pbrugugnoli/Laboratory-Oven/NODEMCU_ESP12E_code/NODEMCU_ESP12E_code.ino

// Example Arduino/ESP8266 code to upload data to Google Sheets
// Follow setup instructions found here:
// https://github.com/StorageB/Google-Sheets-Logging
// 
// email: StorageUnitB@gmail.com


#include <Arduino.h> 
#include <EEPROM.h>
#include <ESP8266WiFi.h>
#include <ESP8266WebServer.h>
#include "HTTPSRedirect.h"
#include "DHTesp.h"
#include <ArduinoJson.h>
#include <ArduinoOTA.h>
#include "C:\Users\pbrug\Documents\01. PEB Personal\Credenciais Cloud\SecurityGit\credentials.h"
#include <PID_v1.h>

// DISABLE DEBUG FOR PRODUCTION
//#define DEBUG_DISABLED true

// SELECT BETWEEN SERIAL or NETWORK DEBUG
#define REMOTE_DEBUG

#ifdef REMOTE_DEBUG
  // OVER NETWORK DEBUG
  #include "RemoteDebug.h"            //https://github.com/JoaoLopesF/RemoteDebug
  #define REMOTE_INITIAL_LEVEL 1      //(VERBOSE)
  #define TELNET_PORT 23
  #define HOST_NAME "remotedebug"
  #define USE_ARDUINO_OTA true
  RemoteDebug Debug;
#else
  // SERIAL DEBUGGER
  #include "SerialDebug.h"           // https://github.com/JoaoLopesF/SerialDebug
  #define DEBUG_INITIAL_LEVEL DEBUG_LEVEL_VERBOSE
  //#define DEBUG_DISABLE_DEBUGGER true
  //#define DEBUG_AUTO_FUNC_DISABLED true
  //#define DEBUG_USE_FLASH_F true   // IMPORTANT FOR ARDUINO - LOW MEMORY
  //#define DEBUG_MINIMUM true       // IMPORTANT FOR ARDUINO - LOW MEMORY    
#endif



// Configuration for fallback access point 
// if Wi-Fi connection fails.
IPAddress AP_IP = IPAddress(10,1,1,1);
IPAddress AP_subnet = IPAddress(255,255,255,0);

// Wi-Fi connection parameters.
// It will be read from the flash during setup.
struct WifiConf {
  char wifi_ssid[50];
  char wifi_password[50];
  // Make sure that there is a 0 
  // that terminatnes the c string
  // if memory is not initalized yet.
  char cstr_terminator = 0; // make sure
};
WifiConf wifiConf;

// Web server for editing configuration.
// 80 is the default http port.
ESP8266WebServer server(80);


// Temperature Sensors
#define DHTpin1 14   //D5 of NodeMCU is GPIO14
#define DHTpin2 12   //D6 of NodeMCU is GPIO12
DHTesp dhtA;
DHTesp dhtB;

// L298N Driver
int ENA = D7;
int IN1 = D1;
int IN2 = D2;

int ENB = D8;
int IN3 = D3;
int IN4 = D4;

// Enter command (insert_row or append_row) and your Google Sheets sheet name (default is Sheet1):
char payload_base[] = "{\"command\": \"insert_row\", \"sheet_name\": \"DataLog\", \"values\": \"%10u,%5.1f,%5.1f,%5.1f,%5.1f,%5.1f,%5.1f,%2s,%10u\"}";
char payload[124] = "";

// Google Sheets setup (do not edit)
const char* host = "script.google.com";
const int httpsPort = 443;
const char* fingerprint = "";
String url = String("/macros/s/") + GScriptId + "/exec";
HTTPSRedirect* client = nullptr;
String json_response;
DynamicJsonDocument doc(1024);

// Declare variables that will be published to Google Sheets
int value0 = 0;
float value1 = 0;
float value2 = 0;
float value3 = 0;
float value4 = 0;
float value5 = 0;
float value6 = 0;
char value7[] = "..";
uint value8;

// Declare reading variables
double humidityA = 0;
double temperatureA = 0;
double humidityB = 0;
double temperatureB = 0;
int minsampleperiod = 2000;     // default min sample period for DHT22 in ms

TempAndHumidity dhtValuesA;
TempAndHumidity dhtValuesB;

// delay control variables
float elapsedTime, currentTime, previousTime;

// controlling parameters
double powerA = 0;
double powerB = 0;
double targetTempA = 30;
double targetTempB = 30;
int max_duty_cycleA = 127;  // =50% ->  [12V (power supply) - 2V (L298N voltage drop)] * max_duty_cycle = 5V
int max_duty_cycleB = 127;  // =50% ->  [12V (power supply) - 2V (L298N voltage drop)] * max_duty_cycle = 5V
int pwmA, pwmB;
double oldTempA, oldTempB;
int counter = 0;
double time_sec;
int time_delay = 60;
double Kp_A = 1, Kp_B = 1;
double Kd_A = 0, Kd_B = 0;
double Ki_A = 0, Ki_B = 0;
bool flagChangeKA = false;
bool flagChangeKB = false;
bool flagChangeDutyA = false;
bool flagChangeDutyB = false;
const int sampleRate = 2000;      // Time interval of the PID control in millisenconds
double debugcounter = 0;          // PEB TO BE DELETED

PID myPIDA (&temperatureA, &powerA, &targetTempA, Kp_A, Ki_A, Kd_A, DIRECT);
PID myPIDB (&temperatureB, &powerB, &targetTempB, Kp_B, Ki_B, Kd_B, DIRECT);


// ------------------------------------------
// SETUP FUNCTION
// ------------------------------------------
void setup() {
  // Serial Communication
  Serial.begin(9600);        
  delay(10000);
   
  // init EEPROM object 
  // to read/write wifi configuration.
  EEPROM.begin(512);
  readWifiConf();

  if (!connectToWiFi()) {
    setUpAccessPoint();
  }
  setUpWebServer();
  setUpOverTheAirProgramming();

	// Initialize RemoteDebug
  #ifdef REMOTE_DEBUG  
    Debug.begin(HOST_NAME, TELNET_PORT, REMOTE_INITIAL_LEVEL); // Initialize the WiFi server
    Debug.setResetCmdEnabled(true); // Enable the reset command
    Debug.showProfiler(true); // Profiler (Good to measure times, to optimize codes)
    Debug.showColors(true); // Colors
  #endif

  // Start Logging
  debugA("\n \n Booting MCU - v1.6 ...\n \n");

  // Onboard LED
  pinMode(LED_BUILTIN, OUTPUT);  // GPIO 16

  // Set Sensor A and B
  debugV("Setting up sensors...");
  dhtA.setup(DHTpin1, DHTesp::DHT11); //for DHT11 Connect DHT sensor to GPIO 14
  dhtB.setup(DHTpin2, DHTesp::DHT11); //for DHT11 Connect DHT sensor to GPIO 12
  minsampleperiod = max(dhtA.getMinimumSamplingPeriod(), dhtB.getMinimumSamplingPeriod());

  // Setup L298N driver pins
  debugV("Setting up L298N pins...");
  pinMode(ENA, OUTPUT);
  pinMode(IN1, OUTPUT);
  pinMode(IN2, OUTPUT); 
  digitalWrite(IN1, HIGH);
  digitalWrite(IN2, LOW);

  pinMode(ENB, OUTPUT);
  pinMode(IN3, OUTPUT);
  pinMode(IN4, OUTPUT); 
  digitalWrite(IN3, LOW);
  digitalWrite(IN4, HIGH);

  // Use HTTPSRedirect class to create a new TLS connection
  debugA("Creating Client for connection...", host);

  client = new HTTPSRedirect(httpsPort);
  client->setInsecure();
  client->setPrintResponseBody(true);
  client->setContentTypeHeader("application/json");
  
  // Try to connect for a maximum of 10 times
  bool flag = false;
  for (int i=0; i<10; i++){ 
    debugA("Trying to connection... %u", i);
    int retval = client->connect(host, httpsPort);
    if (retval == 1){
       flag = true;
       debugA(" - Connected successfully");
       break;
    }
    else
      debugI("Connection failed. Retrying...");
  }
  if (!flag){
    debugA("Could not connect to %s", host);
    return;
  }
 
  // GET data from google sheet - initialize target variables
  get_data_from_sheets(client);
  previousTime = millis(); 

  // Setting up PID controllers
  myPIDA.SetMode(AUTOMATIC);
  myPIDB.SetMode(AUTOMATIC);
  myPIDA.SetSampleTime(sampleRate); // Assign the sample rate of the control
  myPIDB.SetSampleTime(sampleRate); // Assign the sample rate of the control
  myPIDA.SetOutputLimits(0.0, 1.0);
  myPIDB.SetOutputLimits(0.0, 1.0);
  update_PID_settings();

  // clean up
  // delete client;    // delete HTTPSRedirect object
  // client = nullptr; // delete HTTPSRedirect object

}

// ------------------------------------------
// MAIN LOOP
// ------------------------------------------
void loop() {

  // Debug OMM
  debugV("*** Begin Loop - Free Heap Memory:%u\t Max Block Size:%u\n", ESP.getFreeHeap(), ESP.getMaxFreeBlockSize());

  // Give processing time for ArduinoOTA.
  ArduinoOTA.handle();

  // Give processing time for the webserver.
  server.handleClient();

  // Create HTTP client - not necessary as "client" comes from the SETUP
  // static bool flag = false;
  // if (!flag){
  //   client = new HTTPSRedirect(httpsPort);
  //   client->setInsecure();
  //   flag = true;
  //   client->setPrintResponseBody(true);
  //   client->setContentTypeHeader("application/json");
  // }

  // After each time_delay log retrieve parameters from google sheet and write log
  currentTime = millis();                           // get current time
  elapsedTime = (currentTime - previousTime)/1000;  // in seconds
  if (elapsedTime > time_delay) {
    // Turn on LED to indicate processing
    // digitalWrite(LED_BUILTIN, LOW);  it mess up with PWM signal !?!?!
    delay(1000);              // PEB TO BE DELETED
    debugcounter += 0.25;     // PEB TO BE DELETED

    // verify if client is still connected is connected
    if (client != nullptr){
      if (!client->connected()){
        debugI("Client not connected, try to (re)connect...");
        client->connect(host, httpsPort);
        debugI("Client connected status: %u\n", client->connected());
        // it seems to me that a check if the connection is ok
      }
    }
    else{
      debugE("Error creating HTTPSRedirect object!");
    }    

    if (client->connected()){
    // GET data from google sheet
      get_data_from_sheets(client);

    // Update PID
      update_PID_settings();

    // POST data into google sheet 
       post_data_to_sheets(client);
    }

    // Turn off LED
    //digitalWrite(LED_BUILTIN, HIGH);  
    debugI("Free Heap:%u \t Max. Block Size:%u \t Counter:%5.2f\n", ESP.getFreeHeap(), ESP.getMaxFreeBlockSize(), debugcounter); // PEB TO BE DELETED

    previousTime = currentTime;      // the last "trigger time" is stored 
  }

  // Perform controlling activities - Get data from sensors and update heater power
  get_data_from_sensors();
  set_heater_power_with_PID();
  
  // RemoteDebug handle
  debugHandle();
  
  // a delay due to DHT sensor limitations
  delay(minsampleperiod);
}

// -------------------------------------------------------------------
// MAIN LABORATORY OVEN FUNCTIONS (to be replace for a class+methods)
// -------------------------------------------------------------------
void get_data_from_sheets(HTTPSRedirect * client){

  debugI("Getting data from Google Sheet...");

  if(client->GET(url, host, false)){ 
    json_response = client->getResponseBody(); // json_response was declared as global to avoid mem fragmentation

 // Decode JSON/Extract values
    //DynamicJsonDocument doc(1024);          // doc as a global var to avoid mem fragmentation
    debugI(" - Starting deserialization...");
    deserializeJson(doc, json_response);  

    debugI(" - Starting retrieving...");
    targetTempA = doc["targetA"];
    targetTempB = doc["targetB"];
    time_delay = doc["delay"];
    max_duty_cycleA = (int) doc["max_duty_cycleA"];
    max_duty_cycleB = (int) doc["max_duty_cycleB"];

    if ( Kp_A != doc["Kp_A"] ||  Kd_A != doc["Kd_A"] || Ki_A != doc["Ki_A"]){
      flagChangeKA = true;
      Kp_A = doc["Kp_A"];
      Kd_A = doc["Kd_A"];
      Ki_A = doc["Ki_A"];
    } else {
      flagChangeKA = false;
    }

    if ( Kp_B != doc["Kp_B"] ||  Kd_B != doc["Kd_B"] || Ki_B != doc["Ki_B"]){
      flagChangeKB = true;
      Kp_B = doc["Kp_B"];
      Kd_B = doc["Kd_B"];
      Ki_B = doc["Ki_B"];
    } else {
      flagChangeKB = false;
    }

    debugV(" - Data >> Target A:%f\tTarget B:%f\tDelay:%d\tDuty A:%d\tDuty B:%d", targetTempA, targetTempB, time_delay, max_duty_cycleA, max_duty_cycleB);
    debugV(" - Data >> A(Kp, Ki, Kd):(%f , %f, %f)\tB(Kp, Ki, Kd):(%f , %f, %f)\n", Kp_A, Ki_A, Kd_A, Kp_B, Ki_B, Kd_B);

  }
}

void post_data_to_sheets(HTTPSRedirect * client){

  debugI("Publishing data into Google Sheets...");  

  // Update counter
  value0 ++;
  value1 = temperatureA;
  value2 = temperatureB;
  value3 = powerA;
  value4 = powerB;
  value5 = targetTempA;
  value6 = targetTempB;
  // value7 = sensorError;
  value8 = ESP.getFreeHeap(); 

  // prepare payload
  // payload = payload_base + "\"" + value0 + "," + value1+ "," + value2 + "," + value3 + "," + value4 + "," + value5 + "," + value6 + ","  + value7 + ","  + value8 +"\"}";
  sprintf(payload, payload_base, value0, value1, value2, value3, value4, value5, value6, value7, value8);

  if(client->POST(url, host, payload, false)){ 
    // Published data to Google Sheets
    debugV(" - Payload >> %s\n", payload);
  }
  else{
    debugE(" - Error while connecting\n");
  }
}

void get_data_from_sensors(){
  
  debugI("Retrieve data from sensor...");

  // store previous temperatures
  oldTempA = temperatureA;
  oldTempB = temperatureB;

  // Retrieve data from sensor A
  //sensorError = "...";
  counter = 0;
  
  // time in seconds when sensor measures were taken
  time_sec = millis()/1000;

  while (true) {
    dhtValuesA = dhtA.getTempAndHumidity();
    if (dhtA.getStatus() == 0){
      humidityA = dhtValuesA.humidity;
      temperatureA = dhtValuesA.temperature - 1;
      break;
    }
    if (counter++ == 3){
      // sensorError = sensorError + " ErrorA";// + dhtA.getStatusString() + "\t";
      value7[0] = 'A';
      break;
    }
    delay(dhtA.getMinimumSamplingPeriod());
  };

  // Retrieve data from sensor B
  counter = 0;
  while (true) {
    dhtValuesB = dhtB.getTempAndHumidity();
    if (dhtB.getStatus() == 0){
      humidityB = dhtValuesB.humidity;
      temperatureB = dhtValuesB.temperature;
      break;
    }
    if (counter++ == 3){
      //sensorError = sensorError + " ErrorB"; // + dhtB.getStatusString() + "\t";
      value7[1] = 'B';
      break;
    }
    delay(dhtB.getMinimumSamplingPeriod());
  }

  // print status
  debugV(" - Sensor A >> Status:%s\tHumidity:%f\tTemperature:%f",  dhtA.getStatusString(), humidityA, temperatureA);
  debugV(" - Sensor B >> Status:%s\tHumidity:%f\tTemperature:%f\n",  dhtB.getStatusString(), humidityB, temperatureB);
}

void update_PID_settings(){

  debugI("Updating PID settings if necessary...");  

  if (flagChangeKA) {
    myPIDA.SetTunings(Kp_A, Ki_A, Kd_A);
    debugV("PDI parameters for A were updated to (Kp, Ki, Kd) = (%f, %f, %f)", Kp_A, Ki_A, Kd_A);
  }
  if (flagChangeKB) {
    myPIDB.SetTunings(Kp_B, Ki_B, Kd_B);
    debugV("PDI parameters for B were updated to (Kp, Ki, Kd) = (%f, %f, %f)", Kp_B, Ki_B, Kd_B);
  }
  if (flagChangeKA || flagChangeKB) {
  debugV("\n");
  }  
}

void set_heater_power_with_PID(){

  debugI("Setting PWM signals for heater element power...");

  // compute powerA and powerB control signal (0 to 100%)
  myPIDA.Compute();
  myPIDB.Compute();

  // convert scale [0, 100%] into [0, max_duty_cycle] and set PWM signal
  pwmA = (int) round(powerA * max_duty_cycleA);
  pwmB = (int) round(powerB * max_duty_cycleB);

  // set PWM values
  analogWrite(ENA, pwmA);
  analogWrite(ENB, pwmB);

  // print status
  debugV(" - Power >> Heater A:%3.1f\tHeater B:%3.1f", 100*powerA, 100*powerB);
  debugV(" - PWM   >> Heater A:%d\tHeater B:%d\n", pwmA, pwmB);
}

// -------------------------
// OTA CODE AND SAFEGUARDS
// -------------------------
void readWifiConf() {

  debugI("Retrieving data from EEPROM...");

  // Read wifi conf from flash
  for (int i=0; i<sizeof(wifiConf); i++) {
    ((char *)(&wifiConf))[i] = char(EEPROM.read(i));
  }
  // Make sure that there is a 0 
  // that terminatnes the c string
  // if memory is not initalized yet.
  wifiConf.cstr_terminator = 0;
  
  debugV(" - EEPROM >> SSID: %s \t PASS: *******\n");
}

void writeWifiConf() {

  debugI("Writing data into EEPROM...\n");

  for (int i=0; i<sizeof(wifiConf); i++) {
    EEPROM.write(i, ((char *)(&wifiConf))[i]);
  }
  EEPROM.commit();
}

bool connectToWiFi() {
  debugI("Connecting to WiFi - SSID:%s", wifiConf.wifi_ssid);

  WiFi.mode(WIFI_STA); // station mode
  WiFi.setSleepMode(WIFI_NONE_SLEEP);
  WiFi.begin(wifiConf.wifi_ssid, wifiConf.wifi_password);

  if (WiFi.waitForConnectResult() == WL_CONNECTED) {
    debugV(" - Connected with IP: %s\n", WiFi.localIP());
    return true;
  } else {
    debugE(" - Connection to WiFi Failed!\n");
    return false;
  }
}

void setUpAccessPoint() {
    debugI("Setting up access point...");
    debugV(" - SSID: %s\t\t PASS%s", AP_ssid, AP_password);

    WiFi.mode(WIFI_AP_STA);
    WiFi.softAPConfig(AP_IP, AP_IP, AP_subnet);
    if (WiFi.softAP(AP_ssid, AP_password)) {
      debugV(" - Access point set to IP:%s", WiFi.softAPIP());
    } else {
      debugE("Setting up access point failed!");
    }
}

void setUpWebServer() {
  server.on("/", handleWebServerRequest);
  server.begin();
}

void handleWebServerRequest() {

  debugI("Handling web server request...");
  bool save = false;

  if (server.hasArg("ssid") && server.hasArg("password")) {
    server.arg("ssid").toCharArray(
      wifiConf.wifi_ssid,
      sizeof(wifiConf.wifi_ssid));
    server.arg("password").toCharArray(
      wifiConf.wifi_password,
      sizeof(wifiConf.wifi_password));

    writeWifiConf();
    save = true;

    debugV(" - SSID: %s", server.arg("ssid"));

  }

  String message = "";
  message += "<!DOCTYPE html>";
  message += "<html>";
  message += "<head>";
  message += "<title>ESP8266 conf</title>";
  message += "</head>";
  message += "<body>";
  if (save) {
    message += "<div>Saved! Rebooting...</div>";
  } else {
    message += "<h1>Wi-Fi conf</h1>";
    message += "<form action='/' method='POST'>";
    message += "<div>SSID:</div>";
    message += "<div><input type='text' name='ssid' value='" + String(wifiConf.wifi_ssid) + "'/></div>";
    message += "<div>Password:</div>";
    message += "<div><input type='password' name='password' value='" + String(wifiConf.wifi_password) + "'/></div>";
    message += "<div><input type='submit' value='Save'/></div>";
    message += "</form>";
  }
  message += "</body>";
  message += "</html>";
  server.send(200, "text/html", message);

  if (save) {
    debugV("Wi-Fi conf saved. Rebooting...");
    delay(1000);
    ESP.restart();
  }
}

void setUpOverTheAirProgramming() {

  // Change OTA port. 
  // Default: 8266
  ArduinoOTA.setPort(8266);

  // Change the name of how it is going to show up in Arduino IDE.
  ArduinoOTA.setHostname("PEB_NODEMCU_ESP12E");

  // Re-programming passowrd. 
  // ArduinoOTA.setPassword(OTA_password);
  ArduinoOTA.setPasswordHash(OTA_password_hash);

  ArduinoOTA.onStart([]() {
    String type;
    if (ArduinoOTA.getCommand() == U_FLASH) {
      type = "sketch";
    } else {  // U_FS
      type = "filesystem";
    }

    // NOTE: if updating FS this would be the place to unmount FS using FS.end()
    debugI("OTA: Start updating %s", type);
  });

  ArduinoOTA.onEnd([]() {
    debugI("OTA: End update");
  });

  ArduinoOTA.onProgress([](unsigned int progress, unsigned int total) {
    debugV("Progress: %u%%\r", (progress / (total / 100)));
  });

  ArduinoOTA.onError([](ota_error_t error) {
    debugE("Error[%u]: ", error);
    if (error == OTA_AUTH_ERROR) {
      debugE(" - Auth Failed\n");
    } else if (error == OTA_BEGIN_ERROR) {
      debugE(" - Begin Failed\n");
    } else if (error == OTA_CONNECT_ERROR) {
      debugE(" - Connect Failed\n");
    } else if (error == OTA_RECEIVE_ERROR) {
      debugE(" - Receive Failed\n");
    } else if (error == OTA_END_ERROR) {
      debugE(" - End Failed\n");
    }
  });

  ArduinoOTA.begin();
  debugI("OTA: Ready");
}
