pbrugugnoli/Laboratory-Oven/(commit log)

2023-07-25 Initial version of the program form NODEMCU ESP32-E for monitoring and controling the temperature of 2 Laboratory Ovens (estufas)
2023-07-25 Standardize names of boxes, sensors and variables 1->A and 2->B
2023-07-26 Rename NODEMCU_ESP12E_2_channel_temp_controller_V01.ino to Simplest-Laboratory-Oven-with-Controlled-and-Monitored-Temperature.ino
    Adjust program name
2023-07-26 Rename Simplest-Laboratory-Oven-with-Controlled-and-Monitored-Temperature.ino to NODEMCU_ESP12E_LOWCMT
    Messing aroung with names
2023-08-01 Accounting for sensor disconnections and errors
    [NODEMCU_ESP12E_code.ino]
2023-08-04 Google Sheet GET/POST improvement + PID controller
    Generalization of number of parameters to POST and GET with a much nicer and elegant.
    Adjustment of NODEMCU code to handle PID parameters for A nd B.
2023-09-07 Cleanup and reduce usage of String
    Avoid memory segmentation, but it was not enough to eliminate crashes after a few hours - some problem with HTTPSRedirect usage
    [NODEMCU_ESP12E_code.ino, NODEMCU_ESP12E_debug1_only_PID.ino]
